amccaugh/iso320-1k-cryostat/parts-that-need-to-be-re-exported-and-reordered.txt

# Re-export

# Re-order to fix initial version
- 4k plate (1100 aluminum)
- 4k plate (3.2mm copper)
- 40k plate (1100 aluminum)
- 40k plate (3.2mm copper)
- 4k 6-sided copper shield lengths
- 40k 6-sided copper shield lengths
