amccaugh/iso320-1k-cryostat/iso320-1k-cryostat 1K BOM.xlsx

Sheet: iso320-1k-cryostat
Item Description | Where is it used? | # needed | Price | # per pkg | # pkg to buy | Vendor | Part # | Web Page | Sub-Total
CNC and custom vacuum parts
Collar | collar | 1 | $4913 |  | 1 | Hubs.com |  | https://www.hubs.com/ | $4913
Vacuum can - aluminum ISO320 12.75" tube 400mm long | collar | 1 | $2830 |  | 1 | Ancorp | LF320-1200-HN-15.75-CAPPED-AL (400mm) |  | $2830
40k-extender | 40k | 1 | $225 |  | 1 | Hubs.com |  | https://www.hubs.com/ | $225
kf50-sma-feedthrough | collar | 2 | $50 |  | 2 | Hubs.com |  | https://www.hubs.com/ | $100
 |  |  |  |  | 0 |  |  |  | $0
Vacuum hardware |  |  |  |  | 0 |  |  |  | $0
O-ring for RDK101-DL | collar | 1 | $4 | 2 | 1 | McMaster | AS568-154 O-Ring, Viton | https://www.mcmaster.com/9464K285/ | $4
ISO320 single claw clamp | collar | 12 | $6 |  | 12 | LDS Vacuum | ISO320-500-C | https://www.ldsvacuumshopper.com/lf400and500s.html | $72
ISO320 blank + oring + clamp kit | collar | 1 | $609 |  | 1 | LDS Vacuum | ISO320-AB-VE | https://www.ldsvacuumshopper.com/isalbl9.html | $609
ISO320 centering ring + oring | collar | 1 | $184 |  | 1 | LDS Vacuum | ISO320-1200-AR-V | https://www.ldsvacuumshopper.com/lfalcenrinwi.html | $184 |  | Total
NW50 blanks | collar | 12 | $10 |  | 12 | LDS Vacuum | NW50-200-SB | https://www.ldsvacuumshopper.com/qfstainblan2.html | $120 |  | 13697.84
NW50 Bulkhead clamp | collar | 12 | $252 | 10 | 2 | LDS Vacuum | NW50-BC-PK10 | https://www.ldsvacuumshopper.com/nwbucl3.html | $504
NW50 O-rings | collar | 12 | $9 |  | 12 | LDS Vacuum | NW50-200-AR-V | https://www.ldsvacuumshopper.com/qfalcenrinwv2.html | $108
NW40 blanks | collar | 3 | $12 |  | 3 | LDS Vacuum | NW40-150-SB | https://www.ldsvacuumshopper.com/qfstainblan1.html | $36
NW40 bulkhead clamp | collar | 3 | $25 |  | 3 | LDS Vacuum | NW40-150-BC | https://www.ldsvacuumshopper.com/nwbucl2.html | $75
NW40 O-rings | collar | 3 | $8 |  | 3 | LDS Vacuum | NW40-150-SR-V | https://www.ldsvacuumshopper.com/qfstaincenri5.html | $24
NW25 blanks | collar | 2 | $6 |  | 2 | LDS Vacuum | NW25-100-SB | https://www.ldsvacuumshopper.com/qfstainblan.html | $12
NW25 bulkhead clamps | collar | 2 | $23 |  | 2 | LDS Vacuum | NW25-100-BC | https://www.ldsvacuumshopper.com/qfbulclam1.html | $46
NW25 O-rings | collar | 2 | $6 |  | 2 | LDS Vacuum | NW25-100-AR-V | https://www.ldsvacuumshopper.com/qfalcenrinwv.html | $12
NW25 toggle quick release clamp | collar | 2 | $23 |  | 2 | LDS Vacuum | W25-100-CTP | https://www.ldsvacuumshopper.com/nwtoclwicopi1.html | $46
M5 screws - 25 mm | collar | 4 | $11 | 50 | 1 | McMaster |  | https://www.mcmaster.com/91292A129/ | $11
M5 belleville lock washers | collar | 4 | $11 | 25 | 1 | McMaster |  | https://www.mcmaster.com/91477A123/ | $11
NW50 to 1/8" NPT adapter for popoff (blowoff) valve | collar | 1 | $27 |  | 1 | LDS Vacuum | NW50-200-AP12 | https://www.ldsvacuumshopper.com/nwto18nptfem3.html | $27
Popoff (overpressure) valve | collar | 1 | $52 |  | 1 | SunSource | 559B-1M-10 | https://www.sun-source.com/Product/559B-1M-100-CIRCLE-SEAL | $52
10-32 socket head cap screws 5/8" length | spares | 15 | $16 | 100 | 1 | McMaster |  | https://www.mcmaster.com/92196A271/ | $16
10-32 socket head cap screws 1" length | spares | 15 | $21 | 100 | 1 | McMaster |  | https://www.mcmaster.com/92196A274/ | $21
 |  |  |  |  |  |  |  |  | $0
Cryo hardware |  |  |  |  | 0 |  |  |  | $0
Apeizon N grease | 40k,4k,1k | 1 | $380 |  | 1 | Lesker |  | https://www.lesker.com/newweb/fluids/greases-cryogenic-apiezon/apiezonn/ | $380
4-40 socket head cap screws 1/4" length | 1k,4k,40k | 100 | $7 | 100 | 1 | McMaster |  | https://www.mcmaster.com/92196A106/ | $7
4-40 socket head cap screws 3/8" length | 1k,4k,40k | 100 | $8 | 100 | 1 | McMaster |  | https://www.mcmaster.com/92196A108/ | $8
8-32 steel flanged socket head screws | 4k,40k | 24 | $15 | 25 | 1 | McMaster |  | https://www.mcmaster.com/97654A104/ | $15
8-32 steel flanged hex head screws | 4k,40k | 24 | $16 | 100 | 1 | McMaster |  | https://www.mcmaster.com/90316A197/ | $16
4-40 belleville lock washers | 1k,4k,40k | 100 | $16 | 100 | 1 | McMaster |  | https://www.mcmaster.com/90895A121/ | $16
4-40 washers | 1k,4k,40k | 100 | $4 | 100 | 1 | McMaster |  | https://www.mcmaster.com/92141A005/ | $4
M3 screws - 6mm | 1k | 6 | $12 | 100 | 1 | McMaster |  | https://www.mcmaster.com/91292A111/?s=m3+screws | $12
M4 screws - 14 mm | 40k,4k,1k | 36 | $14 | 100 | 1 | McMaster |  | https://www.mcmaster.com/91292A038/ | $14
M4 belleville lock washers | 40k,4k,1k | 36 | $3 | 25 | 2 | McMaster |  | https://www.mcmaster.com/91477A141/ | $6
 |  |  |  |  | 0 |  |  |  | $0
 |  |  |  |  | 0 |  |  |  | $0
Wiring |  |  |  |  | 0 |  |  |  | $0
SMA-to-SMA adapter (bulkhead) | 40k, 4k | 48 | $5.08 |  | 48 | Digikey | ADP-SMAF-SMAF-B-G | https://www.digikey.com/en/products/detail/te-connectivity-linx/ADP-SMAF-SMAF-B-G/11314389 | $243.84
Hermetic SMA-to-SMA adapter (bulkhead) | feedthrough | 16 | $7 |  | 16 | Digikey | AD-SABSAB-001M | https://www.digikey.com/en/products/detail/joymax-electronics/AD-SABSAB-001M/22156072 | $112
SMA-SMA coax copper 0.047" - 150mm length | 40k to 4k | 16 | $37 |  | 16 | Koaxis | AO10-KF047-AO10-150mm-MK | https://koaxis.com/rf-cable-assembly/ao10-kf047-ao10-150mm/ | $592
SMA-SMA coax copper 0.047" - 250mm length | 300k to 40k | 16 | $40 |  | 16 | Koaxis | AO10-KF047-AO10-250mm-MK | https://koaxis.com/rf-cable-assembly/ao10-kf047-ao10-250mm/ | $640
SMA-SMA stainless semirigid 100mm loop 0.085" | 40k, 4k | 32 |  |  | 32 | Intelliconnect CryoCoax |  |  | $0
SMA-SMA stainless semirigid 100mm straight 0.085" | feedthrough | 16 |  |  | 16 | Intelliconnect CryoCoax |  |  | $0
Lakeshore 36AWG quad-wire |  |  |  |  | 0 |  |  |  | $0
Lakeshore 36AWG dual-wire |  |  |  |  | 0 |  |  |  | $0
21pin MicroD |  |  |  |  | 0 |  |  |  | $0
Cryoloom |  |  |  |  | 0 |  |  |  | $0
 |  |  |  |  | 0 |  |  |  | $0
8020 Frame |  |  |  |  | 0 |  |  |  | $0
1/4-20 screw 2-3/8" Long | frame | 4 | $20 | 10 | 1 | McMaster |  | https://www.mcmaster.com/92196A306/ | $20
1/4-20 oversize washers | frame | 4 | $10 | 10 | 1 | McMaster |  | https://www.mcmaster.com/98370A028/ | $10
1/4-20 threaded rod 1-3/4" long | frame | 4 | $7 | 10 | 1 | McMaster |  | https://www.mcmaster.com/95412A548/ | $7
 |  |  |  |  | 0 |  |  |  | $0
 |  |  |  |  | 0 |  |  |  | $0
Other |  |  |  |  | 0 |  |  |  | $0
Stinger vacuum gauge |  |  | $0 |  | 0 |  |  |  | $0
Roughing pump |  |  | $0 |  | 0 |  |  |  | $0
Turbopump |  |  | $0 |  | 0 |  |  |  | $0
Valve |  |  | $0 |  | 0 |  |  |  | $0
Scissor Jack - Vestil CART-200-D Steel Double Scissor Steel Cart | rack | 1 | $665 |  | 1 | materialhandling.com | CART-200-D | https://materialhandling.com/carts/scissor-lift-carts/hydraulic-elevating-carts/vestil-cart-200-d-steel-double-scissor-steel-cart/ | $665
19mm ratching box wrench for M12 bolts | collar | 1 | $44 |  | 1 | McMaster |  | https://www.mcmaster.com/5163A36/ | $44
1/4" ratcheting box wrench for 8/32 flanged screws | 40k,4k | 2 | $12 |  | 2 | McMaster |  | https://www.mcmaster.com/5461A1/ | $24
KF50 to KF25 adapter | spares | 2 | $38 |  | 2 | LDS Vacuum | NW50x25-CR | https://www.ldsvacuumshopper.com/qftoqfconred4.html | $76
KF50 to KF40 adapter | spares | 2 | $38 |  | 2 | LDS Vacuum | NW50x40-CR | https://www.ldsvacuumshopper.com/qftoqfconred5.html | $76
Wire Shelving Unit - 48 x 24 x 86" | rack | 1 | $270 |  | 1 | ULine | H-2946-86 | https://www.uline.com/Product/Detail/H-2946-86/Chrome-Wire-Shelving/Chrome-Wire-Shelving-Unit-48-x-24-x-86 | $270
Wire Shelving Plastic Shelf Liner - 48 x 24", Clear | rack | 6 | $30 |  | 6 | ULine | H-2440C | https://www.uline.com/Product/Detail/H-2440C/Wire-Shelving-Accessories/Plastic-Shelf-Liner-48-x-24-Clear | $180
Wire Shelving Additional Shelves | rack | 2 | $101 |  | 2 | ULine | H-3187C | https://www.uline.com/Product/Detail/H-3187C/Wire-Shelving-Additional-Shelves/Additional-Chrome-Wire-Shelves-48-x-24 | $202
 |  |  |  |  |  |  |  |  |  | 2021-08-18 | SW210601 | 2021-08-19 | Sae Woo Home

Sheet: Old - 1K Krister BOM
 | Where is it used? | Price | # per pkg | # needed | # pkg to buy | Part # | Vendor | Link | Alternate Vendors | Alternate Part # | Alternate links | Sub-Total | Adding Sub-total | Ordered? | Who ordered | Date | PO Number | Expected | Where sent | Where stored | Individual subtotals | Notes
Ideal Vacuum Cube 9x9x9 in. | Cube Frame | $1108 | 1 | 2 | 2 | P109589 | Ideal Vacuum Products | https://www.idealvac.com/en-us/Ideal-Vacuum-Cube-9x9x9-in-Vacuum-Chamber-Frame-6061-T6-Aluminum-Alloy/pp/P109589 |  |  |  | $2216 | $2216 | FALSE |  |  |  |  |  |  | $2216
Ideal Vacuum Cube Hardware Kit, Designed For 9x9x9 Cubes, Includes Viton O-rings And Plate Bolts | Cube Walls to Frame | $74.75 | 1 | 2 | 2 | P109824 | Ideal Vacuum Products | https://www.idealvac.com/Ideal-Vacuum-Cube-Hardware-Kit/pp/P109824 |  |  |  | $149.50 | $2365.5 | FALSE |  |  |  |  |  |  | $2365.5
Ideal Vacuum O-Ring Removal Tool, Non Scratch Polycarbonate, Keeps O-Ring Seals and Grooves from Damage | Install/removing o-rings | $1.20 | 1 | 1 | 1 | P1010547 | Ideal Vacuum Products | https://www.idealvac.com/Ideal-Vacuum-Cube-Plate-Maintenance-and-Service-Tool-Kit/pp/P1010554 |  |  |  | $1.20 | $2366.7 | FALSE |  |  |  |  |  |  | $2366.7
Ideal Vacuum Cube, 9x9x9 in., Multicube Inner Connection Coupling Kit, Includes Hardware and Seals. | Between Two Cube Frames | $429.95 | 1 | 1 | 1 | P1012249 | Ideal Vacuum Products | https://www.idealvac.com/Ideal-Vacuum-Cube/pp/P1012249 |  |  |  | $429.95 | $2796.65 | FALSE |  |  |  |  |  |  | $2796.65
CENTERING RING,QF160,SS INNER AL OUTER,FKM O-RING | iso 160 centering ring | $69.51 | 1 | 1 | 1 | P101769 | Ideal Vacuum Products | https://www.idealvac.com/ISO-160-Centering-Ring-Aluminum-with-Viton-O-Ring-NW-160-Vacuum-Flange-Size-Typically-Used-with-6-Inch-OD-(1524-mm)-Tubing/pp/P101769 |  |  |  | $69.51 | $2866.16 | FALSE |  |  |  |  |  |  | $2866.16
9x9 Plate with ISO-160 port | Top of cube (RDK101 Mount) (1/10) | $289.1 | 1 | 1 | 1 | P1012389 | Ideal Vacuum Products | https://www.idealvac.com/en-us/Ideal-Vacuum-Cube/pp/P1012389 |  |  |  | $289.1 | $3155.26 | FALSE |  |  |  |  |  |  | $3155.26
9x9 Blank Plate | Bot Cube: Bot (2/10) | $181 | 1 | 1 | 1 | P109590 | Ideal Vacuum Products | https://www.idealvac.com/Ideal-Vacuum-Cube-9x9-in-Vacuum-Chamber-Blank-Plate/pp/P109590 |  |  |  | $181 | $3336.26 | FALSE |  |  |  |  |  |  | $3336.26 | Still require 2 x of yellow highlighted items. Only order enoguh for 1 cryostat.
Ideal Vacuum Cube, 9x9 Vacuum Chamber, Plate With 4 KF-40 (NW-40) Pumping of Feedthrough Ports | Top Cube Wall pump out (3/10) | $226.91 | 1 | 1 | 1 | P1010939 | Ideal Vacuum Products | https://www.idealvac.com/Ideal-Vacuum-Cube/pp/P1010939 |  |  |  | $226.91 | $3563.17 | FALSE |  |  |  |  |  |  | $226.91
Ideal Vacuum Cube, 9x9 Vacuum Chamber Plate With One Each KF-50 (NW-50) Pumping or Feedthrough Port | 1 x on top Cube, 1 x on bottom cube (5/10) | $226.91 | 1 | 2 | 2 | P109595 | Ideal Vacuum Products | https://www.idealvac.com/Ideal-Vacuum-Cube/pp/P109595 |  |  |  | $453.82 | $4016.99 | FALSE |  |  |  |  |  |  | $680.73
Ideal Vacuum Cube 9x9 in. Vacuum Chamber Blank Plate, Without Flanged Ports, 6061-T6 Aluminum Alloy | 2x on top, 3x on bottom, 1 extra (11/10) | $226.91 | 1 | 5 | 5 | P109590 | Ideal Vacuum Products | https://www.idealvac.com/Ideal-Vacuum-Cube-9x9-in-Vacuum-Chamber-Blank-Plate/pp/P109590 |  |  |  | $1134.55 | $5151.54 | FALSE |  |  |  |  |  |  | $1815.28
Ideal Vacuum Cube Quick Knob Assembly, Includes Quick Knob, Fastener, Fastening Bolt (1ea) | 3 x on bottom hinge wall | $26.91 | 1 | 3 | 3 | P107936 | Ideal Vacuum Products | https://www.idealvac.com/Ideal-Vacuum-Cube-Quick-Knob-Assembly/pp/P107936 |  |  |  | $80.73 | $5232.27 | FALSE |  |  |  |  |  |  | $1896.01
Custom iso160 full nipple 5.5" length | Ontop of cryostat iso160. Used in place of flexible bellow | $507.24 | 1 | 2 | 2 | ISO160-600-NS | LDS Vacuum | https://www.ldsvacuumshopper.com/isshornip3.html |  |  |  | $1014.48 | $6246.75 | FALSE |  |  |  |  |  |  | $2910.49
ISO-160 Claw Clamp Kit (4x) 5-16/18 | 2x8 For RDK101. REQUIRE LESKER CLAMPS | $4.11 | 1 | 16 | 16 | QF-SSC-ALJ | Lesker | https://www.lesker.com/newweb/flanges/hardware_iso_clamps.cfm?pgid=singleal |  |  |  | $65.76 | $6312.51 | FALSE |  |  |  |  |  |  | $2976.25
Chemical-Resistant Viton® Fluoroelastomer O-Ring 1/8 Fractional Width, Dash Number 240 | RDK101 O-ring, 1 for use, 1 extra | $12.86 | 5 | 1 | 1 | 9464K69 | McMaster-Carr | https://www.mcmaster.com/9464K69/ |  |  |  | $12.86 | $6325.37 | FALSE |  |  |  |  |  |  | $2989.11
Copper Foil 1 Mill | 1x for 40K, 1x for 4K | $64.22 | 1 | 2 | 2 | 9709K11 | McMaster-Carr | https://www.mcmaster.com/9709K11/ |  |  |  | $128.44 | $6453.81 | FALSE |  |  |  |  |  |  | $3117.55
Belleville Disc Spring for 3/16" Shaft Diameter, 0.190" ID, 0.375" OD, 0.0180" Thick | Tension 4K & 40K plates 5x per screw. ,7 screws | $8.78 | 12 | 35 | 3 | 9712K15 | McMaster-Carr | https://www.mcmaster.com/9712K15/ |  |  |  | $26.34 | $6480.15 | FALSE |  |  |  |  |  |  | $3143.89
18-8 Stainless Steel Socket Head Screw 1/4"-20 Thread Size, 3/8" Long | Idela vac adapter plate to bottom idealvac wall | $19.67 | 50 | 8 | 1 | 92196A535 | McMaster-Carr | https://www.mcmaster.com/92196A535/ |  |  |  | $19.67 | $6499.82 | FALSE |  |  |  |  |  |  | $3163.56
18-8 Stianless Steel M5 20 mm 0.8mm Coarse Socket Head Screws (Maybe get 22 mm? 1mm left at bottom of screw) | RDK to Top Adapter plate | $16.66 | 100 | 4 | 1 | 91292A128 | McMaster-Carr | https://www.mcmaster.com/91292A128 |  |  |  | $16.66 | $6516.48 | FALSE |  |  |  |  |  |  | $3180.22
18-8 Stainless Steel Split Lock Washer for M5 Screw Size, 5.3 mm ID, 10 mm OD | RDK to Top Adapter plate | $3.52 | 100 | 4 | 1 | 92148A170 | McMaster-Carr | https://www.mcmaster.com/92148A170/ |  |  |  | $3.52 | $6520 | FALSE |  |  |  |  |  |  | $3183.74
18-8 Stainless Steel Socket Head Screw 4-40 Thread Size, 3/16" Long | 40K Walls (48 per side *4) and Top plate block Plates (32 for both top plates). 4K walls (21 per side *4) + 2 plates (8 * 2). 40K strap requires 16 screws. Total is 340 screws | $5.36 | 100 | 324 | 4 | 92196A105 | McMaster-Carr | https://www.mcmaster.com/92196A105/ |  |  |  | $21.44 | $6541.44 | FALSE |  |  |  |  |  |  | $3205.18
18-8 Stainless Steel Socket Head Screw 4-40 Thread Size, 5/16" Long | Top plates (4) & 40K (4) into bar stock | $6.26 | 100 | 8 | 1 | 92196A107 | McMaster-Carr | https://www.mcmaster.com/92196A107/ |  |  |  | $6.26 | $6547.7 | FALSE |  |  |  |  |  |  | $3211.44
Belleville Disc Spring for 1/8" Shaft Diameter, 0.125" ID, 0.25" OD, 0.0130" Thick | Top 40K plates (4) & Bottom 40K (4) into bar stock = 8 *5 Top 4K plates (4) and Bottom 4K plates (4) = 8 * 5. Total is 40 (40K) + 40 (4K) = 80 | $7.48 | 12 | 80 | 7 | 9712K54 | McMaster-Carr | https://www.mcmaster.com/9712K54/ |  |  |  | $52.36 | $6600.06 | FALSE |  |  |  |  |  |  | $3263.80
Aluminum Socket Head Screw M4 x 0.7 mm Thread, 16 mm Long | Cold Heads. Long enough to accomidate sandwhich cold straps. Total is 8 + 6 = 14 | $9.35 | 5 | 3 | 1 | 98511A743 | McMaster-Carr | https://www.mcmaster.com/98511A743/ |  |  |  | $9.35 | $6609.41 |  |  |  |  |  |  |  | $3273.15
18-8 Stainless Steel Socket Head Screw 1/4"-20 Thread Size, 3/8" Long | Cold strap plates to 40K and 4K cold head. 4 (40K) + 8 (4K) = total of 12 | $9.86 | 100 | 12 | 1 | 92196A191 | McMaster-Carr | https://www.mcmaster.com/92196A191/ |  |  |  | $9.86 | $6619.27 |  |  |  |  |  |  |  | $3283.01
18-8 Stainless Steel Socket Head Screw 6-32 Thread Size, 5/8" Long | Require 12 to fasten 1K stage to 4K stage. Also require12 for 4K heat strap | $8.83 | 100 | 24 | 1 | 92196A150 | McMaster-Carr | https://www.mcmaster.com/92196A150/ |  |  |  | $8.83 | $6628.1 |  |  |  |  |  |  |  | $3291.84
303 Stainless Steel Knurled Knob with 10-24 Threaded Hole, 3/8" Deep, 3/4" Diameter Head | 40K Walls (Knobs are $6.61 for 10 or more) | $6.61 | 1 | 8 | 8 | 60205K64 | McMaster-Carr | https://www.mcmaster.com/60205K64/ |  |  |  | $52.88 | $6680.98 |  |  |  |  |  |  |  | $3344.72
18-8 Stainless Steel Socket Head Screw 10-24 Thread Size, 3/8" Long | 40K wall knobs | $13.10 | 100 | 8 | 1 | 92196A240 | McMaster-Carr | https://www.mcmaster.com/92196A240/ |  |  |  | $13.10 | $6694.08 |  |  |  |  |  |  |  | $3357.82
Stainless Steel Raised Knurled-Head Thumb Screw 4-40 Thread Size, 1/4" Long, 3/8" Diameter Head | 4K walls | $7.36 | 1 | 4 | 4 | 60205K64 | McMaster-Carr | https://www.mcmaster.com/60205K64/ |  |  |  | $29.44 | $6723.52 |  |  |  |  |  |  |  | $3387.26
Belleville Spring Lock Washer 17-7 PH Stainless Steel, for Number 6 Screw Size, 0.143" ID, 0.341" OD | Require 12 to fasten 1K stage to 4K stage. Also require12 for 4K heat strap | $14.30 | 50 | 12 | 1 | 91235A102 | McMaster-Carr | https://www.mcmaster.com/91235a102/ |  |  |  | $14.30 | $6737.82
Stainless Steel Raised Knurled-Head Thumb Screw 4-40 Thread Size, 1/4" Long, 3/8" Diameter Head | 4K knobs | $3.80 | 1 | 4 | 4 | 91830A101 | McMaster-Carr | https://www.mcmaster.com/91830A101/ |  |  |  | $15.20 | $6753.02
 |  |  |  |  |  |  |  |  |  |  | Total: | $6753.02

Sheet: Old - Second ORDER BOM
Items for One Cryostat | Where is it used? | Price | # per pkg | # needed | # pkg to buy | Part # | Vendor | Link | Alternate Vendors | Alternate Part # | Alternate links | Sub-Total | Adding Sub-total | Ordered? | Who ordered | Date | PO Number | Expected | Where sent | Where stored | Individual subtotals | Notes
Ideal Vacuum Cube, 9x9 Vacuum Chamber, Plate With 4 KF-40 (NW-40) Pumping of Feedthrough Ports |  | $226.91 | 1 | 1 | 1 | P1010939 | Ideal Vacuum Products | https://www.idealvac.com/Ideal-Vacuum-Cube/pp/P1010939 |  |  |  | $226.91 | $226.91 | FALSE |  | SKW | SW240364 | 2024-07-12 |  |  | $226.91
Ideal Vacuum Cube, 9x9 Vacuum Chamber Plate With One Each KF-50 (NW-50) Pumping or Feedthrough Port | 1 x on top Cube, 1 x on bottom cube (5/10) | $226.91 | 1 | 2 | 2 | P109595 | Ideal Vacuum Products | https://www.idealvac.com/Ideal-Vacuum-Cube/pp/P109595 |  |  |  | $453.82 | $680.73 | FALSE |  | SKW | SW240364 | 2024-07-12 |  |  | $680.73
Ideal Vacuum Cube 9x9 in. Vacuum Chamber Blank Plate, Without Flanged Ports, 6061-T6 Aluminum Alloy | 2x on top, 3x on bottom, 1 extra (11/10) | $226.91 | 1 | 5 | 5 | P109590 | Ideal Vacuum Products | https://www.idealvac.com/Ideal-Vacuum-Cube-9x9-in-Vacuum-Chamber-Blank-Plate/pp/P109590 |  |  |  | $1134.55 | $1815.28 | FALSE |  | SKW | SW240364 | 2024-07-12 |  |  | $1815.28
Ideal Vacuum Cube Quick Knob Assembly, Includes Quick Knob, Fastener, Fastening Bolt (1ea) | 3 x on bottom hinge wall | $26.91 | 1 | 3 | 3 | P107936 | Ideal Vacuum Products | https://www.idealvac.com/Ideal-Vacuum-Cube-Quick-Knob-Assembly/pp/P107936 |  |  |  | $80.73 | $1896.01 | FALSE |  | SKW | SW240364 | 2024-07-12 |  |  | $1896.01
Custom iso160 full nipple 5.5" length | Ontop of cryostat iso160. Used in place of flexible bellow | $507.24 | 1 | 2 | 2 | ISO160-600-NS | LDS Vacuum | https://www.ldsnipplefabricator.com/ |  |  |  | $1014.48 | $2910.49 | FALSE |  | SKW | SW240365 | 5 days Pending mfg |  |  | $2910.49
ISO-160 Claw Clamp Kit (4x) 5-16/18 | 2x8 For RDK101. REQUIRE LESKER CLAMPS | $4.11 | 1 | 8 | 8 | QF-SSC-ALJ | Lesker | https://www.lesker.com/newweb/flanges/hardware_iso_clamps.cfm?pgid=singleal |  |  |  | $32.88 | $2943.37 | FALSE |  | SKW | SW240366 | 2024-07-12 |  |  | $2943.37
Chemical-Resistant Viton® Fluoroelastomer O-Ring 1/8 Fractional Width, Dash Number 240 | RDK101 O-ring, 1 for use, 1 extra | $12.86 | 5 | 1 | 1 | 9464K69 | McMaster-Carr | https://www.mcmaster.com/9464K69/ |  |  |  | $12.86 | $2956.23 | FALSE |  | SKW | SW240367 | 2024-07-12 |  |  | $2956.23
Copper Foil 1 Mill | 1x for 40K, 1x for 4K | $64.22 | 1 | 2 | 2 | 9709K11 | McMaster-Carr | https://www.mcmaster.com/9709K11/ |  |  |  | $128.44 | $3084.67 | FALSE |  | SKW | SW240367 | 2024-07-12 |  |  | $3084.67
Belleville Disc Spring for 3/16" Shaft Diameter, 0.190" ID, 0.375" OD, 0.0180" Thick | Tension 4K & 40K plates 5x per screw. ,7 screws | $8.78 | 12 | 35 | 3 | 9712K15 | McMaster-Carr | https://www.mcmaster.com/9712K15/ |  |  |  | $26.34 | $3111.01 | FALSE |  | SKW | SW240367 | 2024-07-12 |  |  | $3111.01
18-8 Stainless Steel Socket Head Screw 1/4"-20 Thread Size, 3/8" Long | Idela vac adapter plate to bottom idealvac wall | $19.67 | 50 | 8 | 1 | 92196A535 | McMaster-Carr | https://www.mcmaster.com/92196A535/ |  |  |  | $19.67 | $3130.68 | FALSE |  | SKW | SW240367 | 2024-07-12 |  |  | $3130.68
18-8 Stianless Steel M5 20 mm 0.8mm Coarse Socket Head Screws (Maybe get 22 mm? 1mm left at bottom of screw) | RDK to Top Adapter plate | $16.66 | 100 | 4 | 1 | 91292A128 | McMaster-Carr | https://www.mcmaster.com/91292A128 |  |  |  | $16.66 | $3147.34 | FALSE |  | SKW | SW240367 | 2024-07-12 |  |  | $3147.34
18-8 Stainless Steel Split Lock Washer for M5 Screw Size, 5.3 mm ID, 10 mm OD | RDK to Top Adapter plate | $3.52 | 100 | 4 | 1 | 92148A170 | McMaster-Carr | https://www.mcmaster.com/92148A170/ |  |  |  | $3.52 | $3150.86 | FALSE |  | SKW | SW240367 | 2024-07-12 |  |  | $3150.86
18-8 Stainless Steel Socket Head Screw 4-40 Thread Size, 3/16" Long | 40K Walls (48 per side *4) and Top plate block Plates (32 for both top plates). 4K walls (21 per side *4) + 2 plates (8 * 2). 40K strap requires 16 screws. Total is 340 screws | $5.36 | 100 | 324 | 4 | 92196A105 | McMaster-Carr | https://www.mcmaster.com/92196A105/ |  |  |  | $21.44 | $3172.30 | FALSE |  | SKW | SW240367 | 2024-07-12 |  |  | $3172.30
18-8 Stainless Steel Socket Head Screw 4-40 Thread Size, 5/16" Long | Top plates (4) & 40K (4) into bar stock | $6.26 | 100 | 8 | 1 | 92196A107 | McMaster-Carr | https://www.mcmaster.com/92196A107/ |  |  |  | $6.26 | $3178.56 | FALSE |  | SKW | SW240367 | 2024-07-12 |  |  | $3178.56
Belleville Disc Spring for 1/8" Shaft Diameter, 0.125" ID, 0.25" OD, 0.0130" Thick | Top 40K plates (4) & Bottom 40K (4) into bar stock = 8 *5 Top 4K plates (4) and Bottom 4K plates (4) = 8 * 5. Total is 40 (40K) + 40 (4K) = 80 | $7.48 | 12 | 80 | 7 | 9712K54 | McMaster-Carr | https://www.mcmaster.com/9712K54/ |  |  |  | $52.36 | $3230.92 | FALSE |  | SKW | SW240367 | 2024-07-12 |  |  | $3230.92
Aluminum Socket Head Screw M4 x 0.7 mm Thread, 16 mm Long | Cold Heads. Long enough to accomidate sandwhich cold straps. Total is 8 + 6 = 14 | $9.35 | 5 | 3 | 1 | 98511A743 | McMaster-Carr | https://www.mcmaster.com/98511A743/ |  |  |  | $9.35 | $3240.27 |  |  | SKW | SW240367 | 2024-07-12 |  |  | $3240.27
18-8 Stainless Steel Socket Head Screw 1/4"-20 Thread Size, 3/8" Long | Cold strap plates to 40K and 4K cold head. 4 (40K) + 8 (4K) = total of 12 | $9.86 | 100 | 12 | 1 | 92196A191 | McMaster-Carr | https://www.mcmaster.com/92196A191/ |  |  |  | $9.86 | $3250.13 |  |  | SKW | SW240367 | 2024-07-12 |  |  | $3250.13
18-8 Stainless Steel Socket Head Screw 6-32 Thread Size, 5/8" Long | Require 12 to fasten 1K stage to 4K stage. Also require12 for 4K heat strap | $8.83 | 100 | 24 | 1 | 92196A150 | McMaster-Carr | https://www.mcmaster.com/92196A150/ |  |  |  | $8.83 | $3258.96 |  |  | SKW | SW240367 | 2024-07-12 |  |  | $3258.96
303 Stainless Steel Knurled Knob with 10-24 Threaded Hole, 3/8" Deep, 3/4" Diameter Head | 40K Walls (Knobs are $6.61 for 10 or more) | $6.61 | 1 | 8 | 8 | 60205K64 | McMaster-Carr | https://www.mcmaster.com/60205K64/ |  |  |  | $52.88 | $3311.84 |  |  | SKW | SW240367 | 2024-07-12 |  |  | $3311.84
18-8 Stainless Steel Socket Head Screw 10-24 Thread Size, 3/8" Long | 40K wall knobs | $13.10 | 100 | 8 | 1 | 92196A240 | McMaster-Carr | https://www.mcmaster.com/92196A240/ |  |  |  | $13.10 | $3324.94 |  |  | SKW | SW240367 | 2024-07-12 |  |  | $3324.94
Stainless Steel Raised Knurled-Head Thumb Screw 4-40 Thread Size, 1/4" Long, 3/8" Diameter Head | 4K walls | $7.36 | 1 | 4 | 4 | 60205K64 | McMaster-Carr | https://www.mcmaster.com/60205K64/ |  |  |  | $29.44 | $3354.38 |  |  | SKW | SW240367 | 2024-07-12 |  |  | $3354.38
 |  |  |  |  | #DIV/0! |  |  |  |  |  |  | #DIV/0! | #DIV/0!
 |  |  |  |  | 0 |  |  |  |  |  |  | $0.00 | #DIV/0!
 |  |  |  |  |  |  |  |  |  |  | Total: | #DIV/0!
