amccaugh/iso320-1k-cryostat/cnc/300k-collar.step

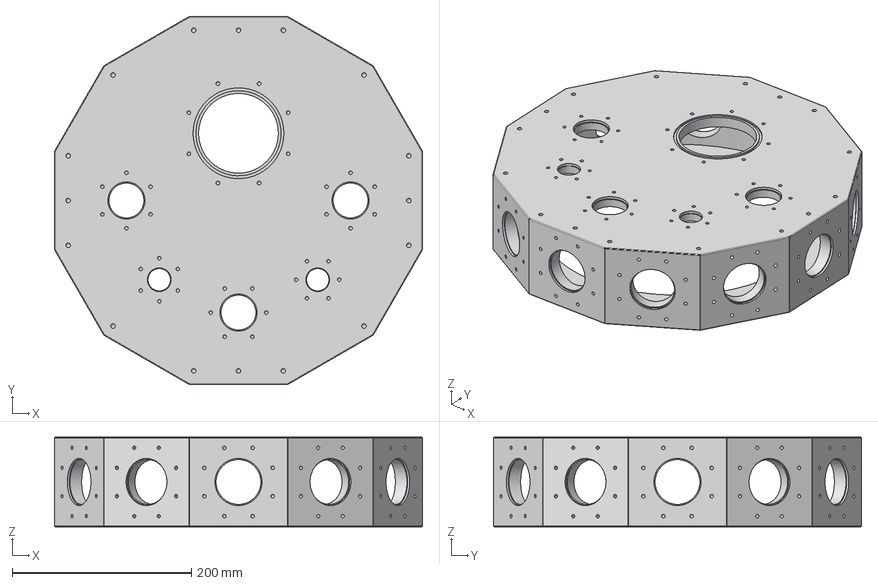
[picture p1: CAD file, 2026-10-22]
cnc/300k-collar.step
410.5 x 410.5 x 100.0 mm
