amccaugh/iso320-1k-cryostat/sheet-metal/40k/40k - Flat pattern of 40k-plate.dxf

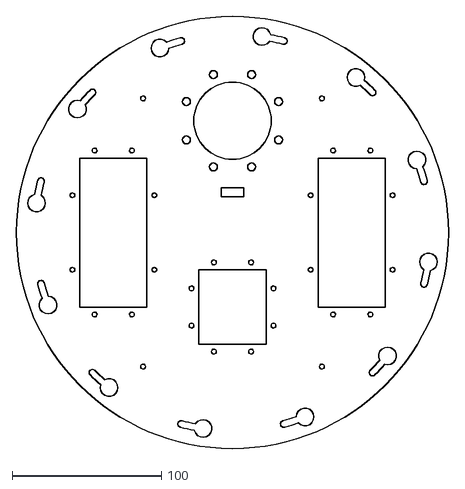
[picture p2: CAD file, 2026-10-22]
sheet-metal/40k/40k - Flat pattern of 40k-plate.dxf
290.0 x 290.0
