amccaugh/iso320-1k-cryostat/sheet-metal/4k/4k - Flat pattern of 4k-plate.dxf

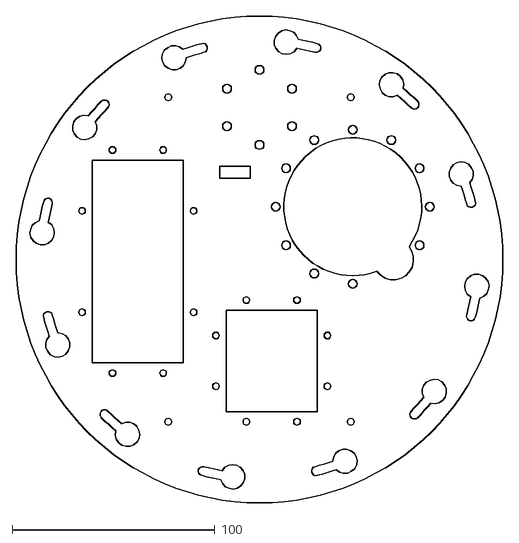
[picture p3: CAD file, 2026-10-22]
sheet-metal/4k/4k - Flat pattern of 4k-plate.dxf
240.0 x 240.0
