amccaugh/iso320-1k-cryostat/sheet-metal/g10-supports - Flat pattern of g10-support-bottom.dxf

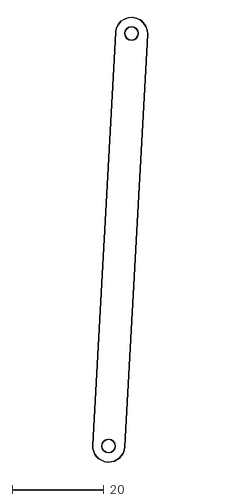
[picture p4: CAD file, 2026-09-02]
sheet-metal/g10-supports - Flat pattern of g10-support-bottom.dxf
12.2 x 97.5
