amccaugh/iso320-1k-cryostat/cnc/40k-extender.step

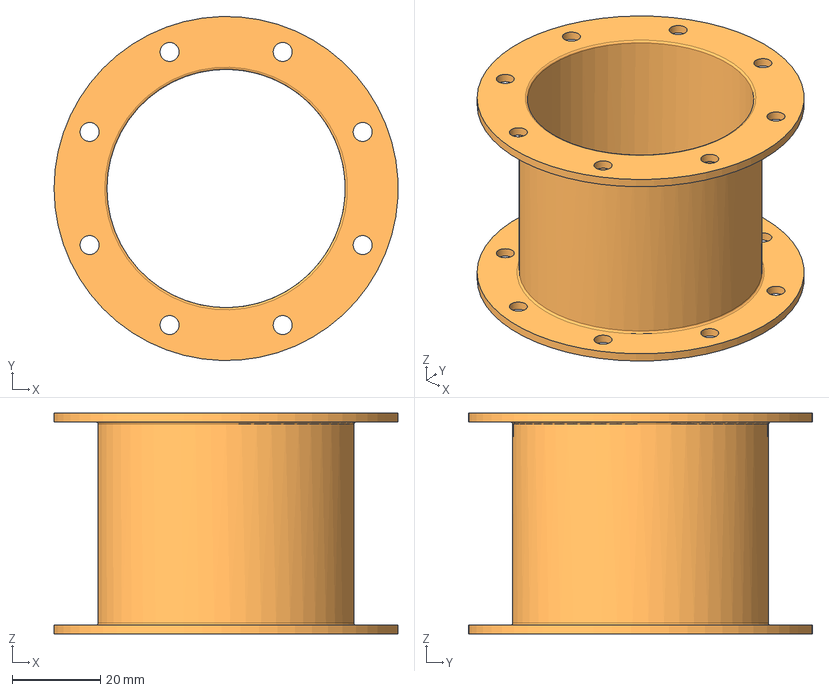
[picture p5: CAD file, 2026-10-22]
cnc/40k-extender.step
77.9 x 78.0 x 50.0 mm
