amccaugh/iso320-1k-cryostat/sheet-metal/1k-mount-plate - Flat pattern of 1k-mount-plate.dxf

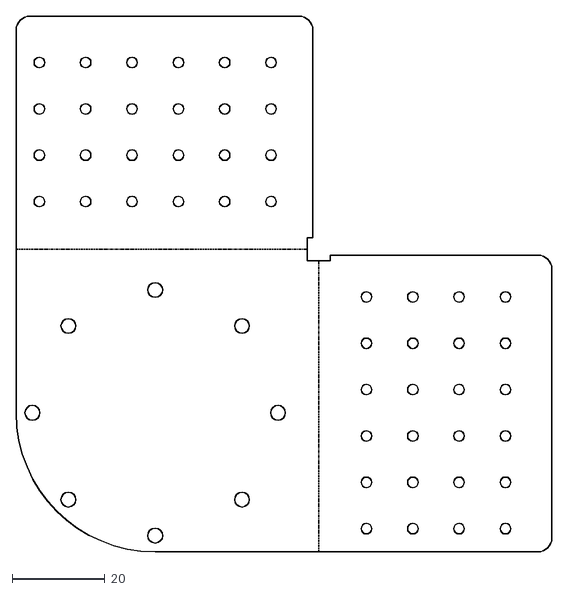
[picture p6: CAD file, 2026-09-02]
sheet-metal/1k-mount-plate - Flat pattern of 1k-mount-plate.dxf
115.6 x 115.6
