amccaugh/iso320-1k-cryostat/sheet-metal/40k/40k - Flat pattern of 40k-slot-cover-small.dxf

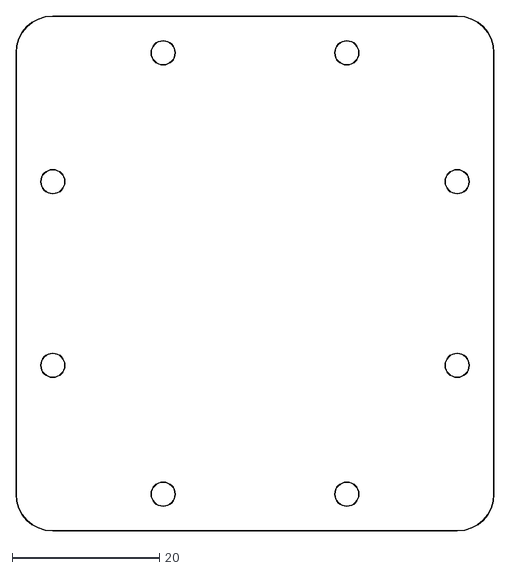
[picture p7: CAD file, 2026-10-22]
sheet-metal/40k/40k - Flat pattern of 40k-slot-cover-small.dxf
65.0 x 70.0
