amccaugh/iso320-1k-cryostat/sheet-metal/4k/4k - Flat pattern of 4k-shield-length.dxf

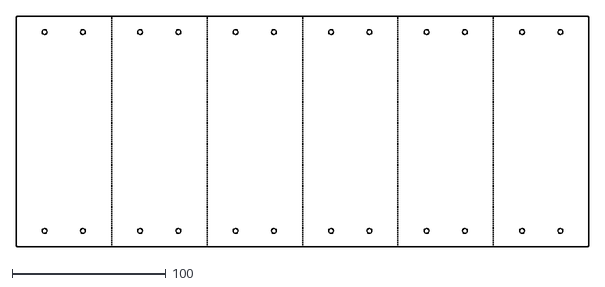
[picture p8: CAD file, 2026-10-22]
sheet-metal/4k/4k - Flat pattern of 4k-shield-length.dxf
373.2 x 150.0
