amccaugh/iso320-1k-cryostat/sheet-metal/40k/40k - Flat pattern of 40k-shield-length.dxf

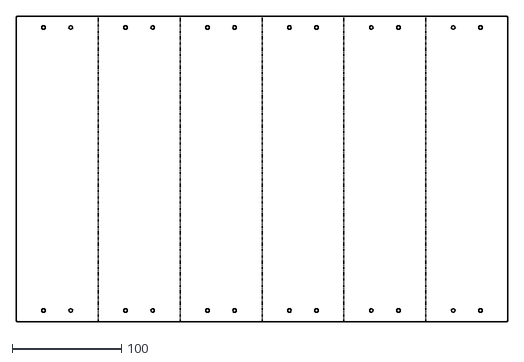
[picture p9: CAD file, 2026-10-22]
sheet-metal/40k/40k - Flat pattern of 40k-shield-length.dxf
450.8 x 280.0
