amccaugh/iso320-1k-cryostat/sheet-metal/4k/4k - Flat pattern of 4k-shield-bottom.dxf

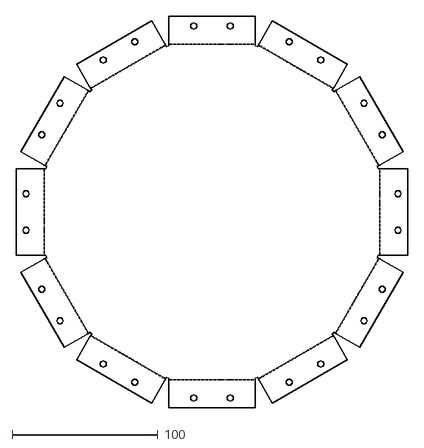
[picture p10: CAD file, 2026-09-01]
sheet-metal/4k/4k - Flat pattern of 4k-shield-bottom.dxf
268.8 x 268.8
