amccaugh/iso320-1k-cryostat/sheet-metal/g10-mount - Flat pattern of Part 1(1).dxf

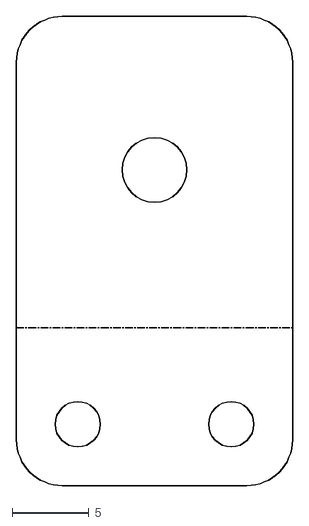
[picture p11: CAD file, 2026-09-02]
sheet-metal/g10-mount - Flat pattern of Part 1(1).dxf
18.0 x 30.6
