amccaugh/iso320-1k-cryostat/sheet-metal/40k/40k - Flat pattern of 40k-slot-cover-large.dxf

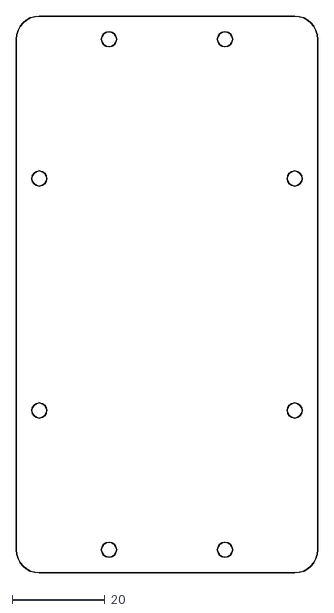
[picture p12: CAD file, 2026-10-22]
sheet-metal/40k/40k - Flat pattern of 40k-slot-cover-large.dxf
65.0 x 120.0
