amccaugh/iso320-1k-cryostat/sheet-metal/4k/4k - Flat pattern of 4k-shield-top.dxf

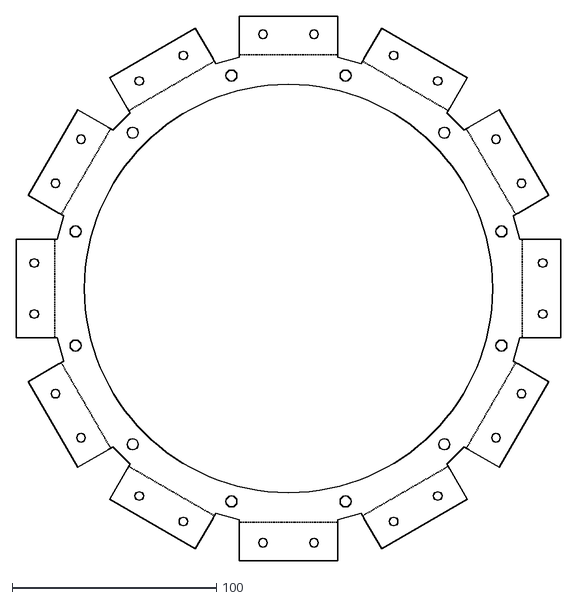
[picture p13: CAD file, 2026-09-01]
sheet-metal/4k/4k - Flat pattern of 4k-shield-top.dxf
266.6 x 266.6
