amccaugh/iso320-1k-cryostat/sheet-metal/g10-supports - Flat pattern of g10-support-top.dxf

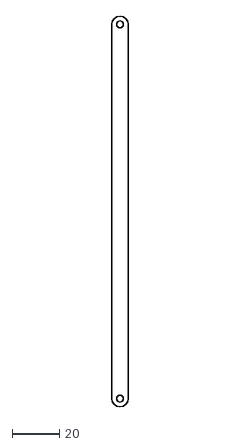
[picture p14: CAD file, 2026-09-02]
sheet-metal/g10-supports - Flat pattern of g10-support-top.dxf
7.00 x 165.3
