amccaugh/iso320-1k-cryostat/sheet-metal/40k/16x-sma-slot-cover-large - Flat pattern of 16x-sma-slot-cover-large.dxf

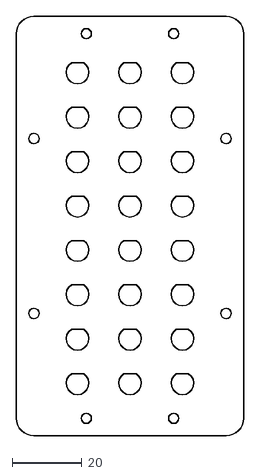
[picture p15: CAD file, 2026-08-21]
sheet-metal/40k/16x-sma-slot-cover-large - Flat pattern of 16x-sma-slot-cover-large.dxf
65.0 x 120.0
