amccaugh/iso320-1k-cryostat/sheet-metal/40k/40k - Flat pattern of 40k-shield-bottom.dxf

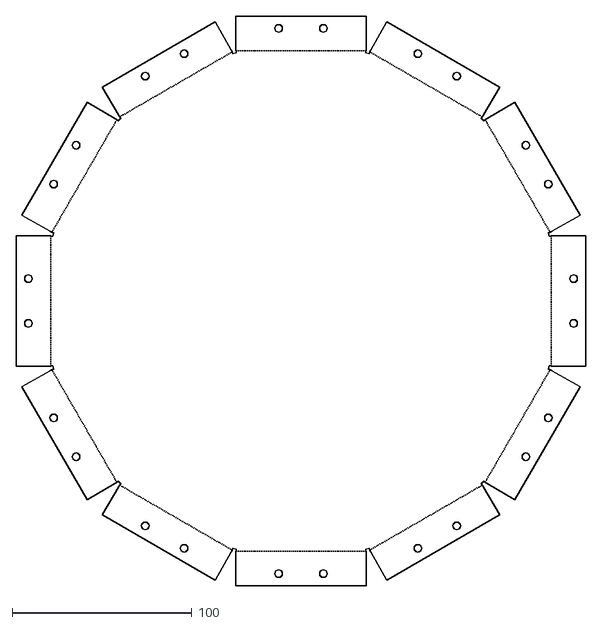
[picture p16: CAD file, 2026-08-21]
sheet-metal/40k/40k - Flat pattern of 40k-shield-bottom.dxf
317.1 x 317.1
