amccaugh/iso320-1k-cryostat/sheet-metal/40k/40k - Flat pattern of 40k-shield-top.dxf

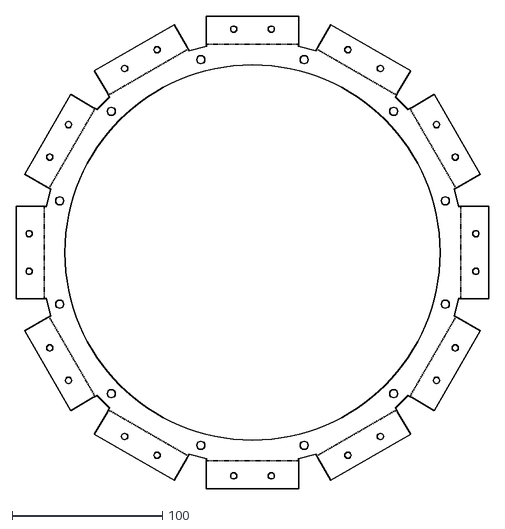
[picture p17: CAD file, 2026-08-21]
sheet-metal/40k/40k - Flat pattern of 40k-shield-top.dxf
314.9 x 314.9
