amccaugh/iso320-1k-cryostat/cnc/300k-collar-drawing.pdf

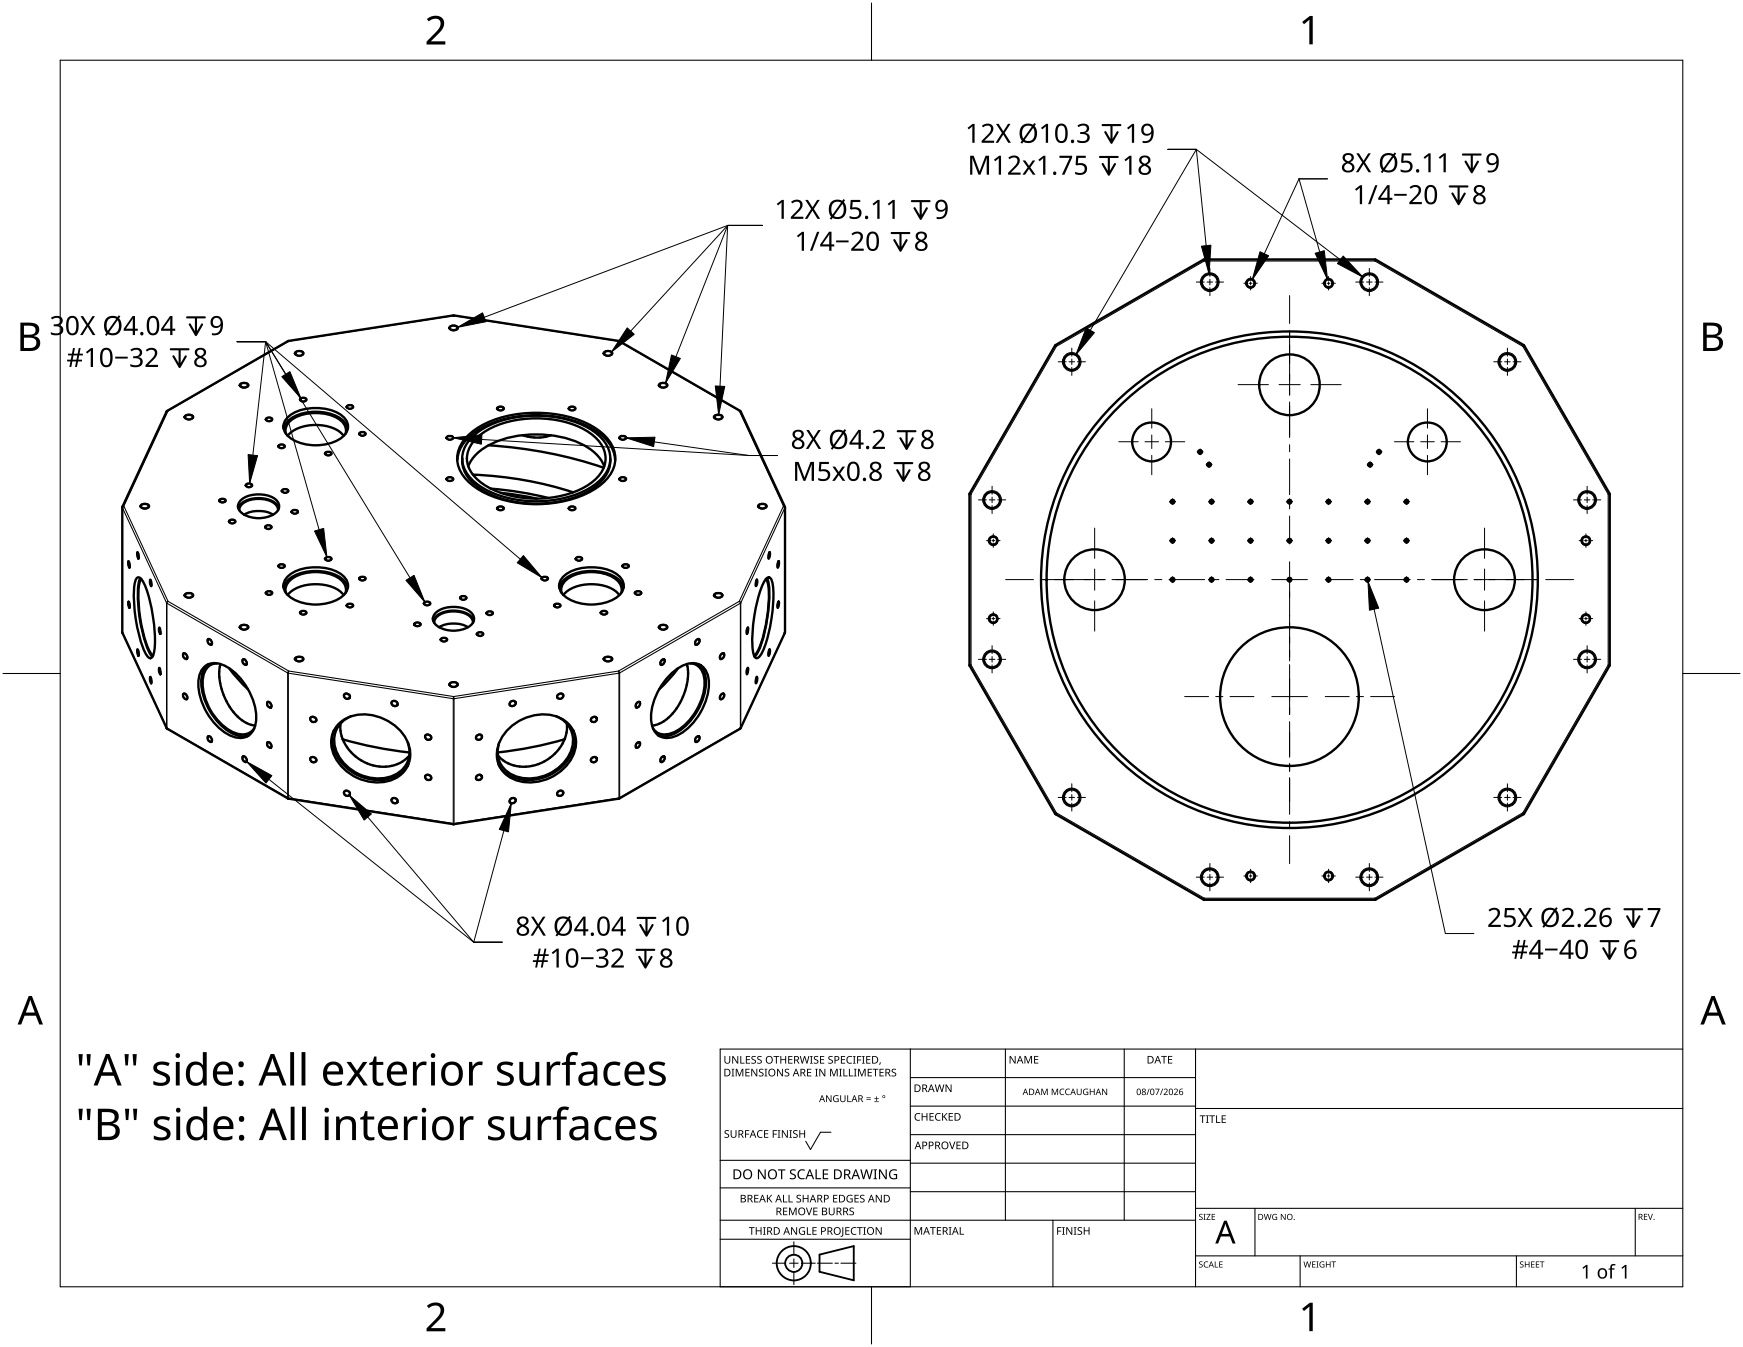
[picture p18: page 1]
