amccaugh/iso320-1k-cryostat/cnc/kf50-sma-feedthrough-drawing.pdf

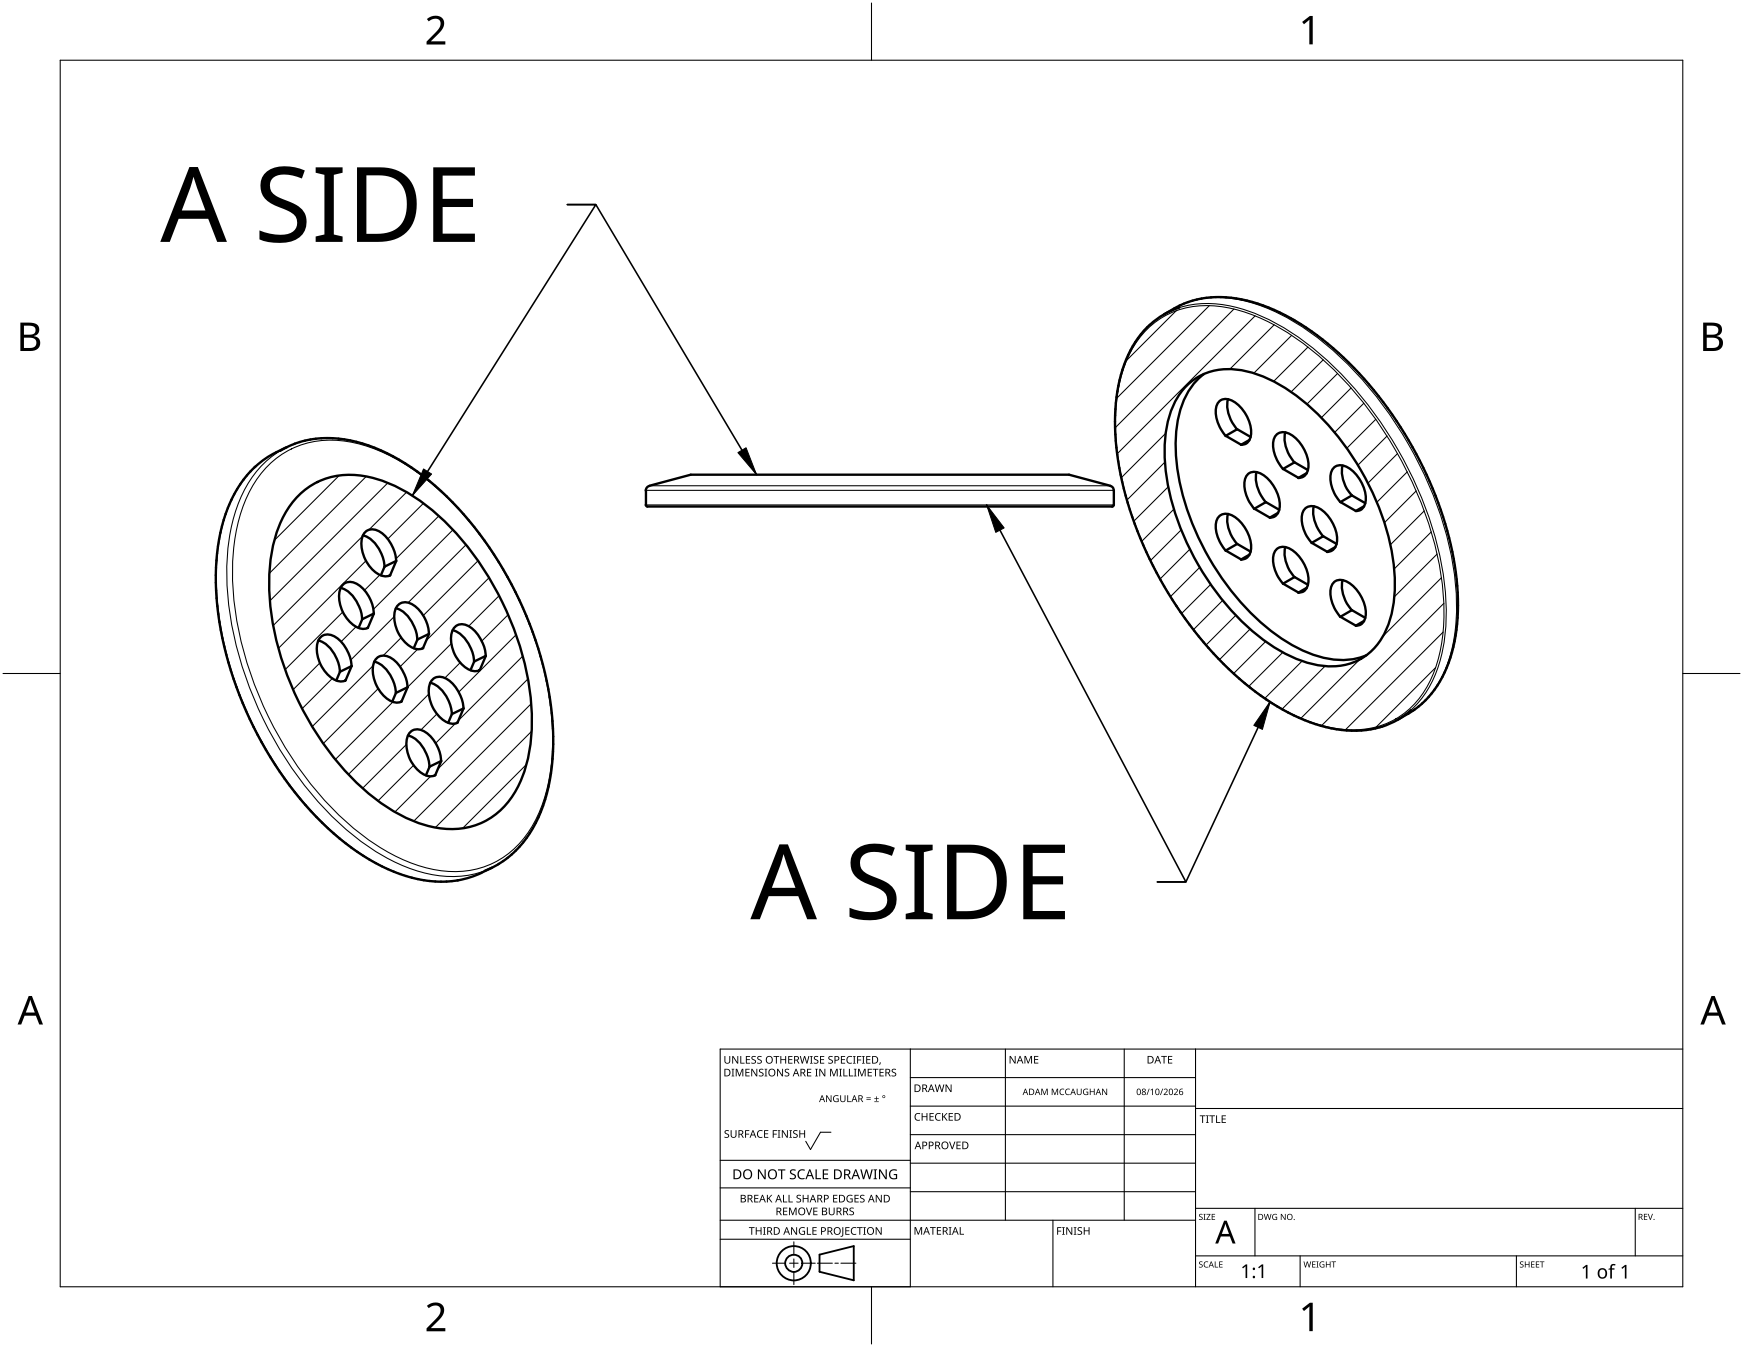
[picture p19: page 1]
