amccaugh/iso320-1k-cryostat/(commit log)

2026-09-02 Update iso320-1k-cryostat 1K BOM.xlsx
    [iso320-1k-cryostat 1K BOM.xlsx]
2026-10-22 Update 40k - Flat pattern of 40k-plate.dxf
